c-MM/c-replicator/README.md

# c-replicator
stuff for the second c-replicator
