c-MM/c-replicator/3d-print/replicator-ZEN6-buttons-panel-v1.stl

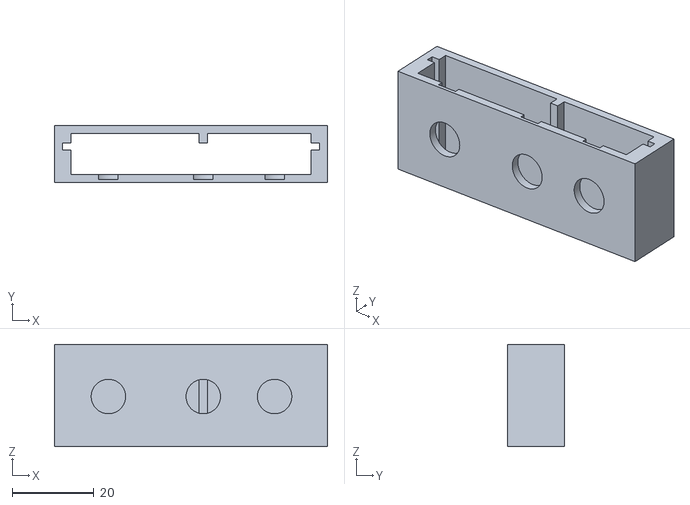
[picture p1: CAD file, 2019-01-27]
3d-print/replicator-ZEN6-buttons-panel-v1.stl
66.6 x 14.0 x 25.0
