c-MM/c-replicator/3d-print/replicator-ZEN6-cashbox-v1.stl

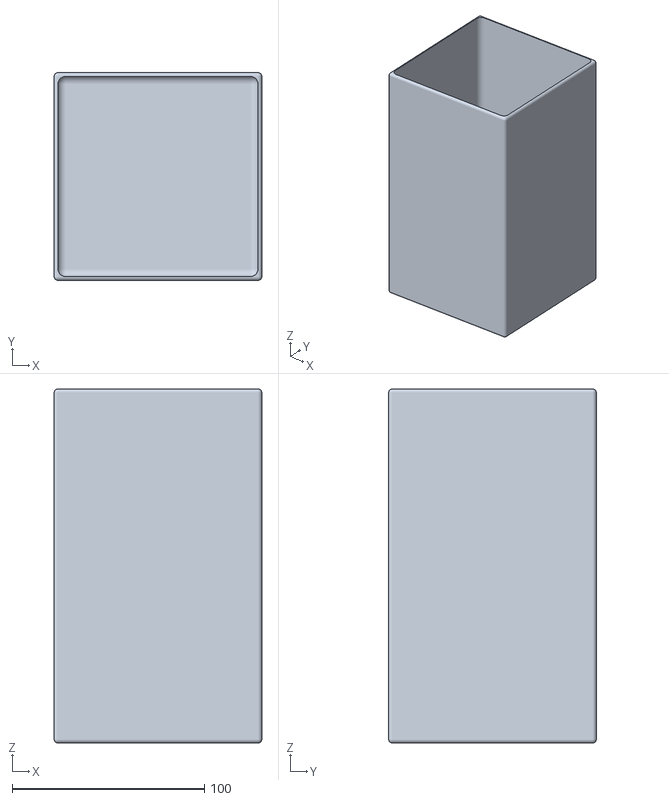
[picture p2: CAD file, 2019-01-26]
3d-print/replicator-ZEN6-cashbox-v1.stl
108.0 x 108.0 x 184.0
