c-MM/c-replicator/3d-print/replicator-ZEN6-connector_holder-v1.stl

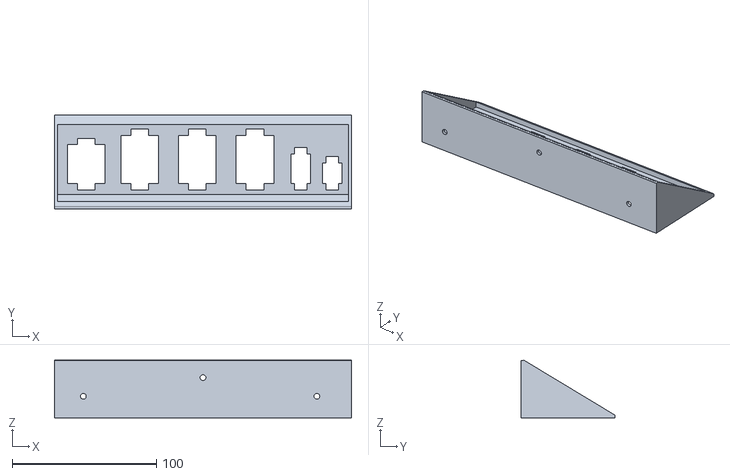
[picture p3: CAD file, 2019-01-20]
3d-print/replicator-ZEN6-connector_holder-v1.stl
206.0 x 65.0 x 40.1
