c-MM/c-replicator/kicad/logic/logic.pdf

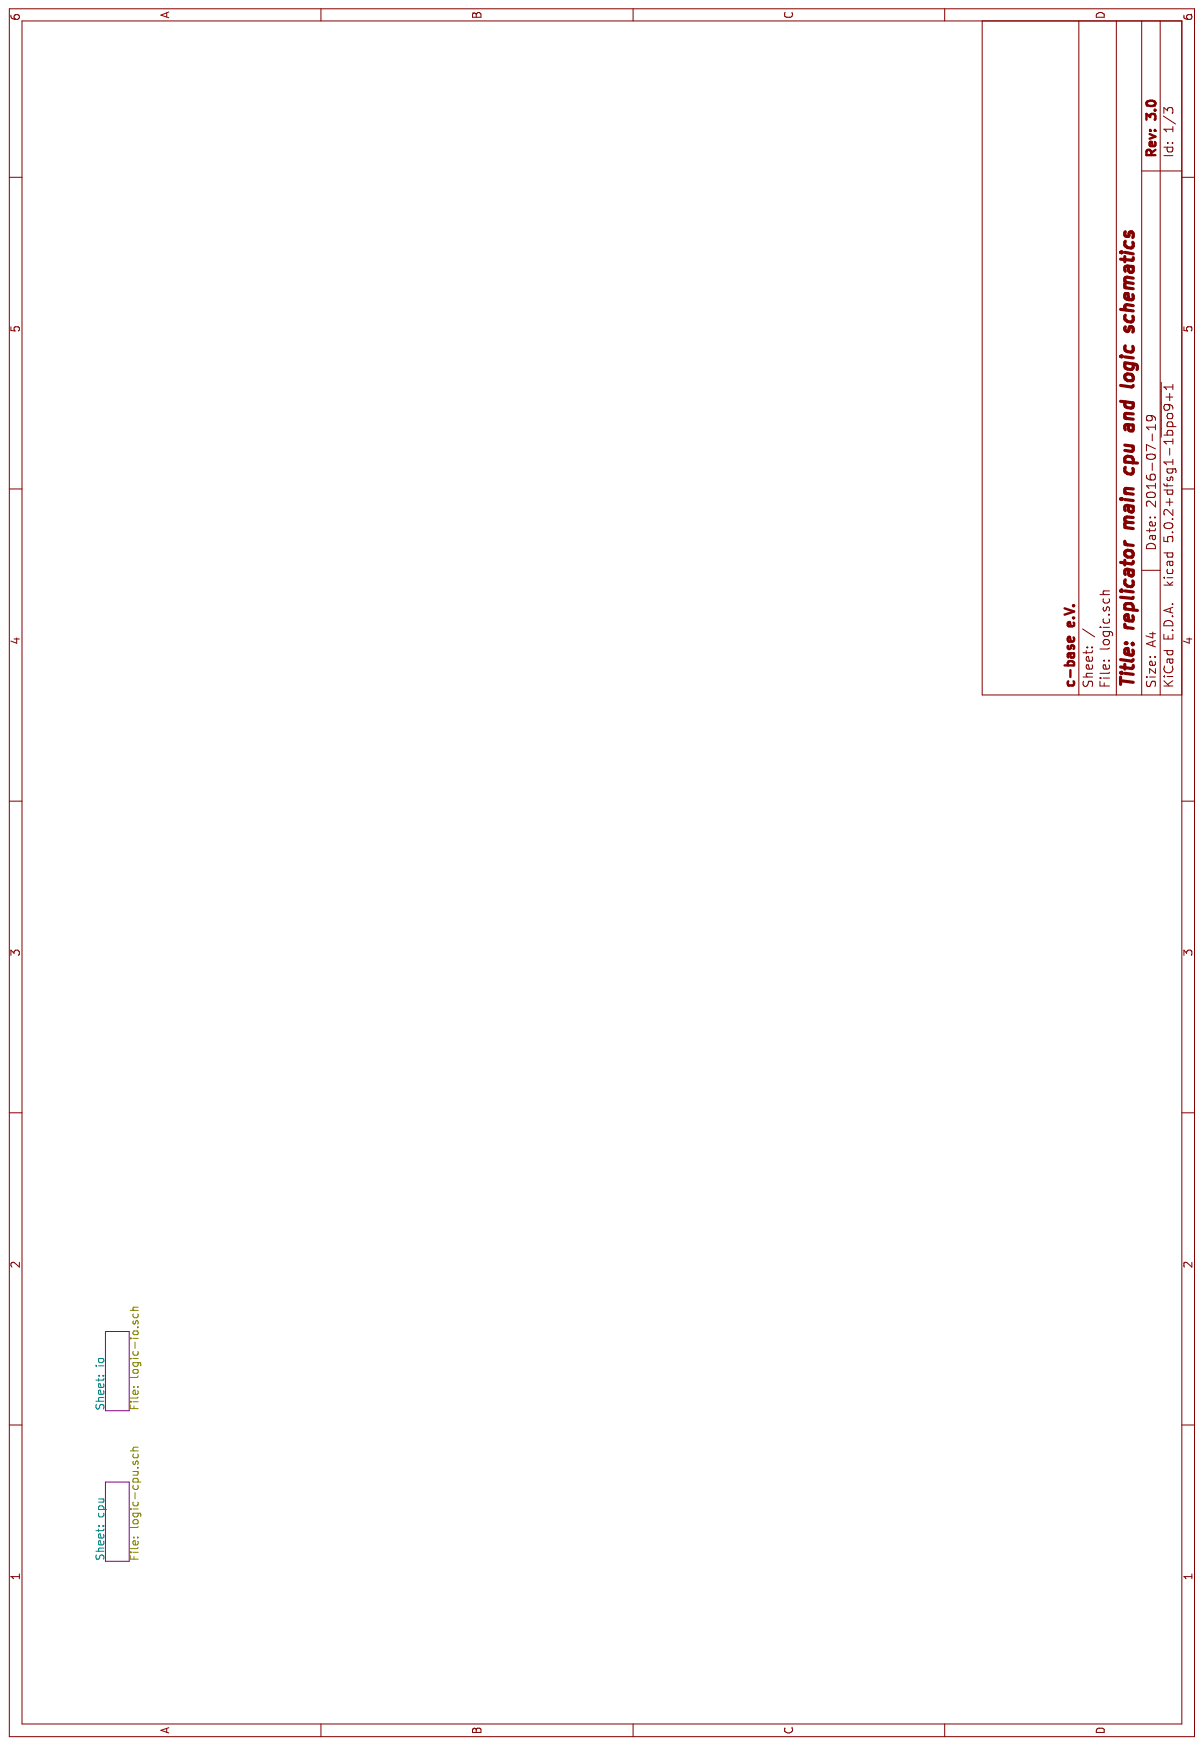
[picture p4: page 1]

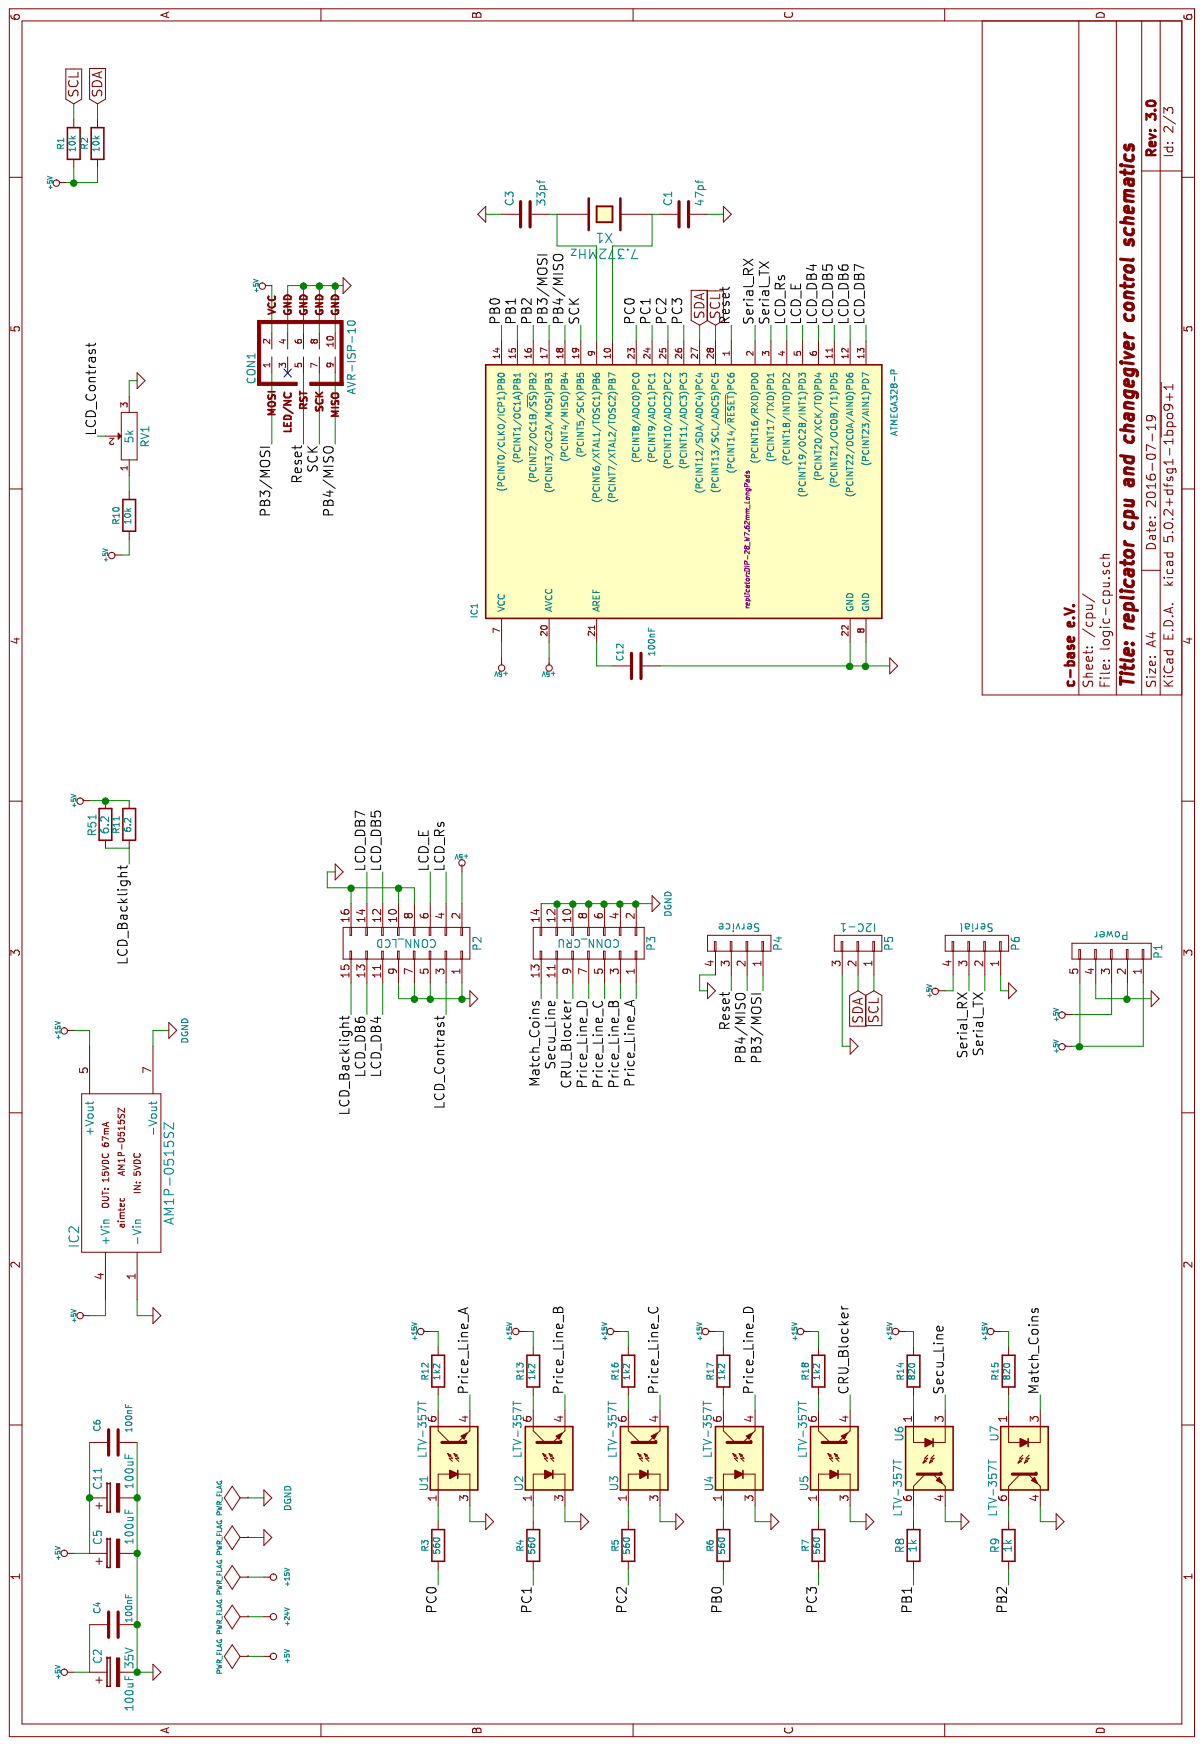
[picture p5: page 2]

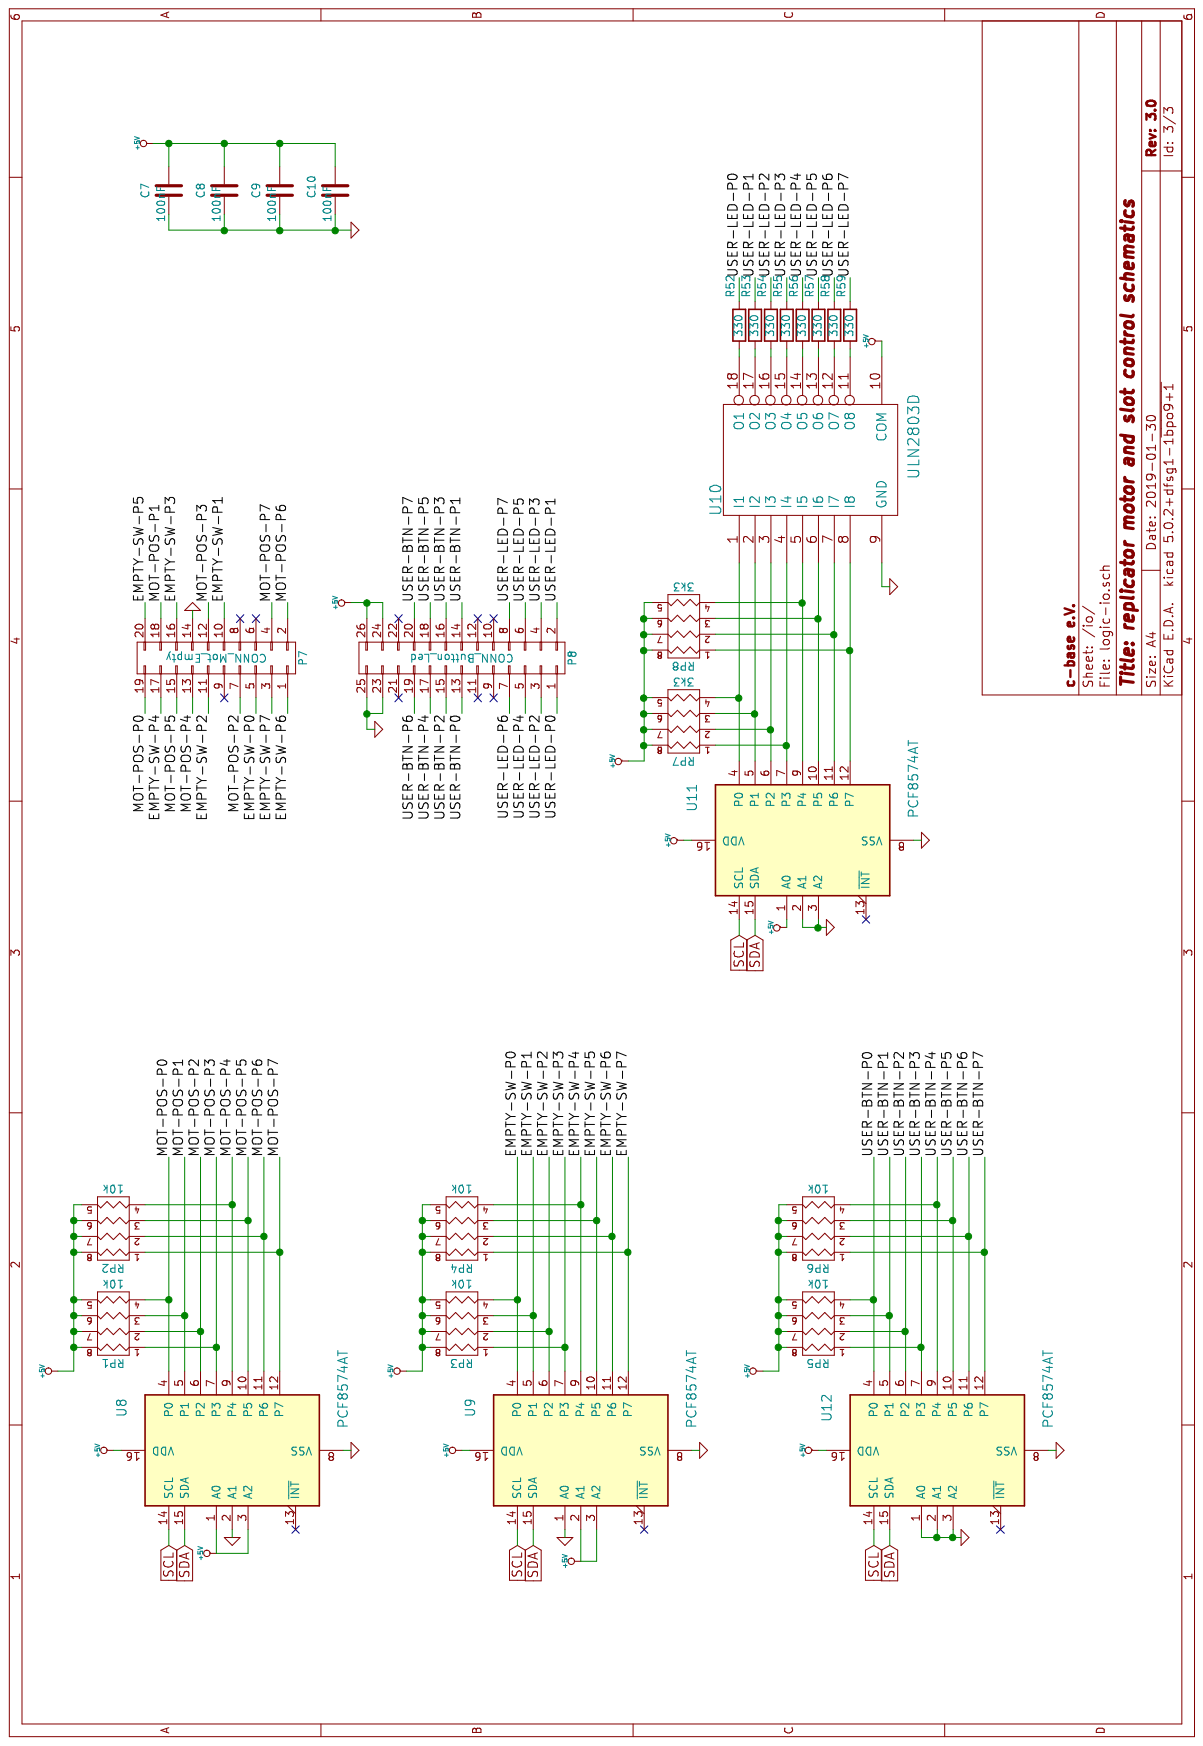
[picture p6: page 3]
