c-MM/c-replicator/kicad/power/power.pdf

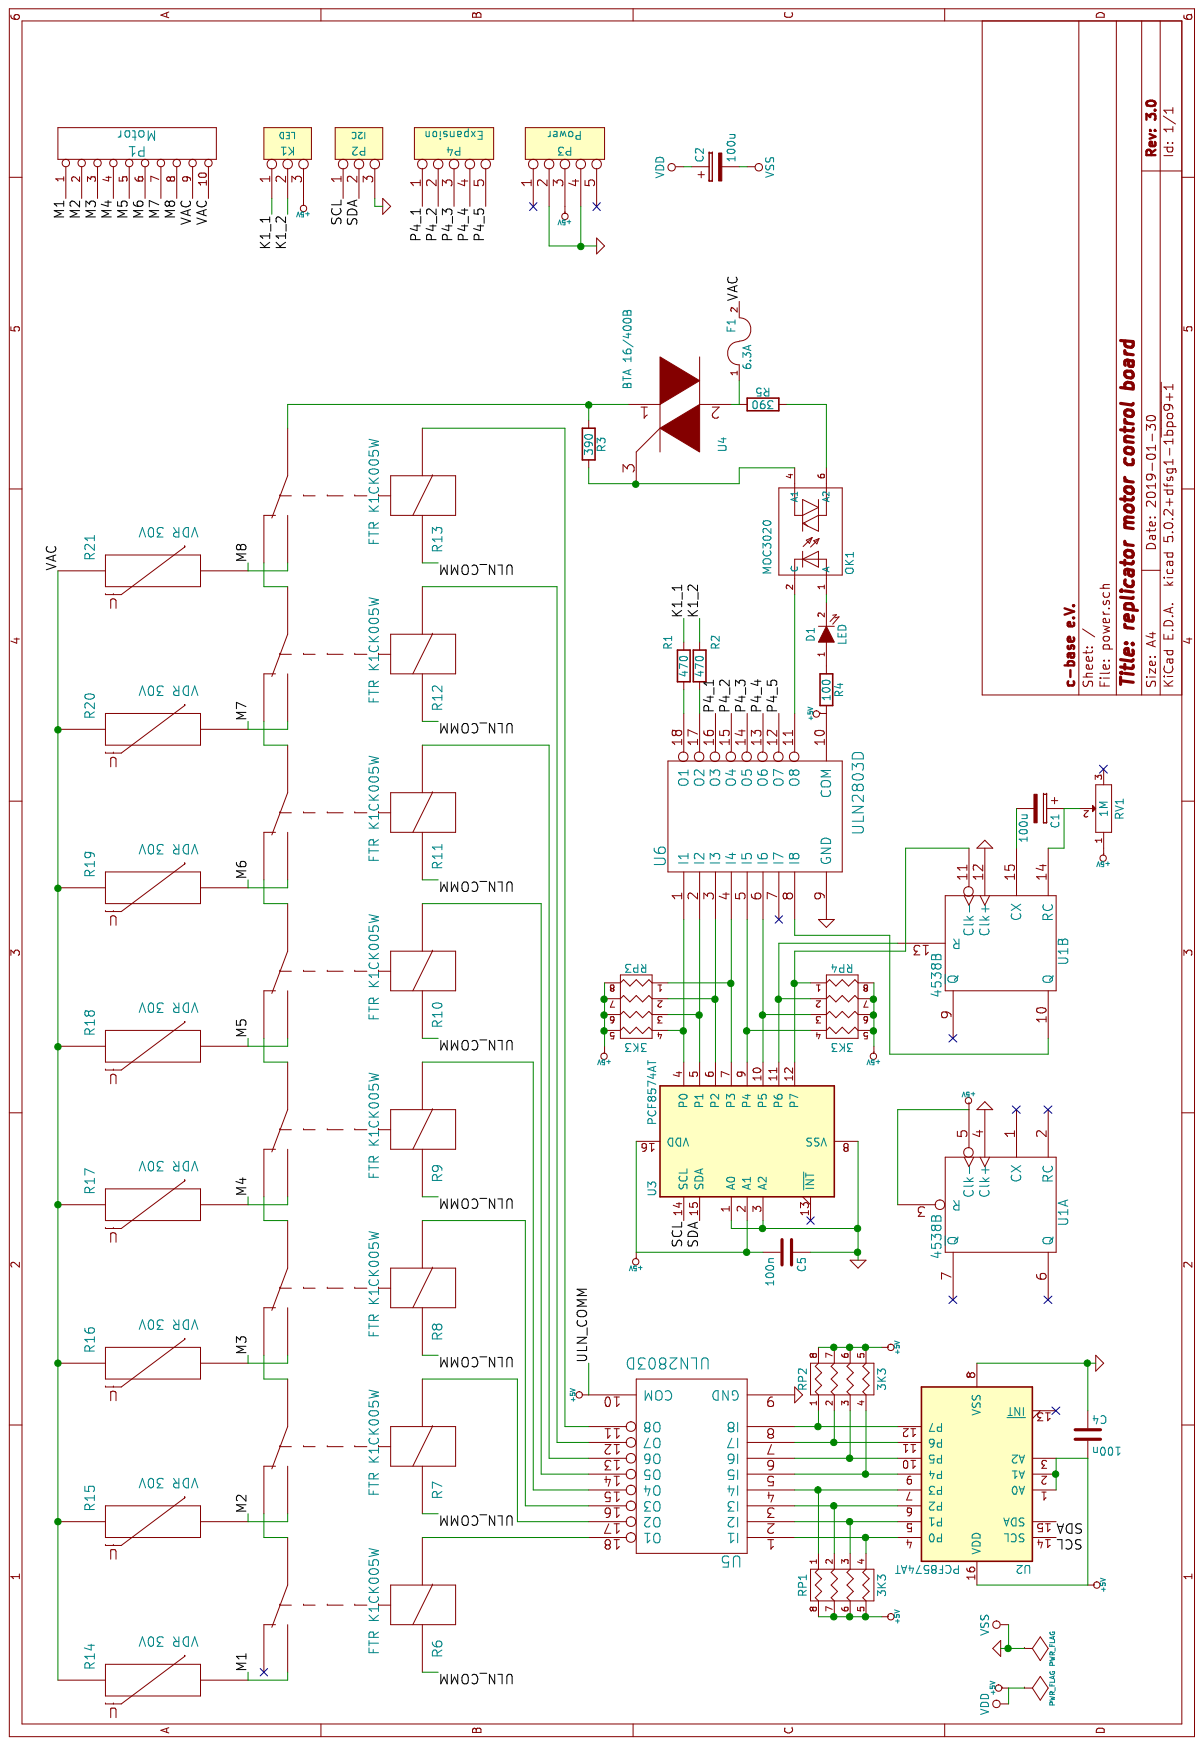
[picture p7: page 1]
