c-MM/c-replicator/kicad/power/power.kicad_pcb

## KiCad design kicad/power/power.kicad_pcb (2019-01-30)

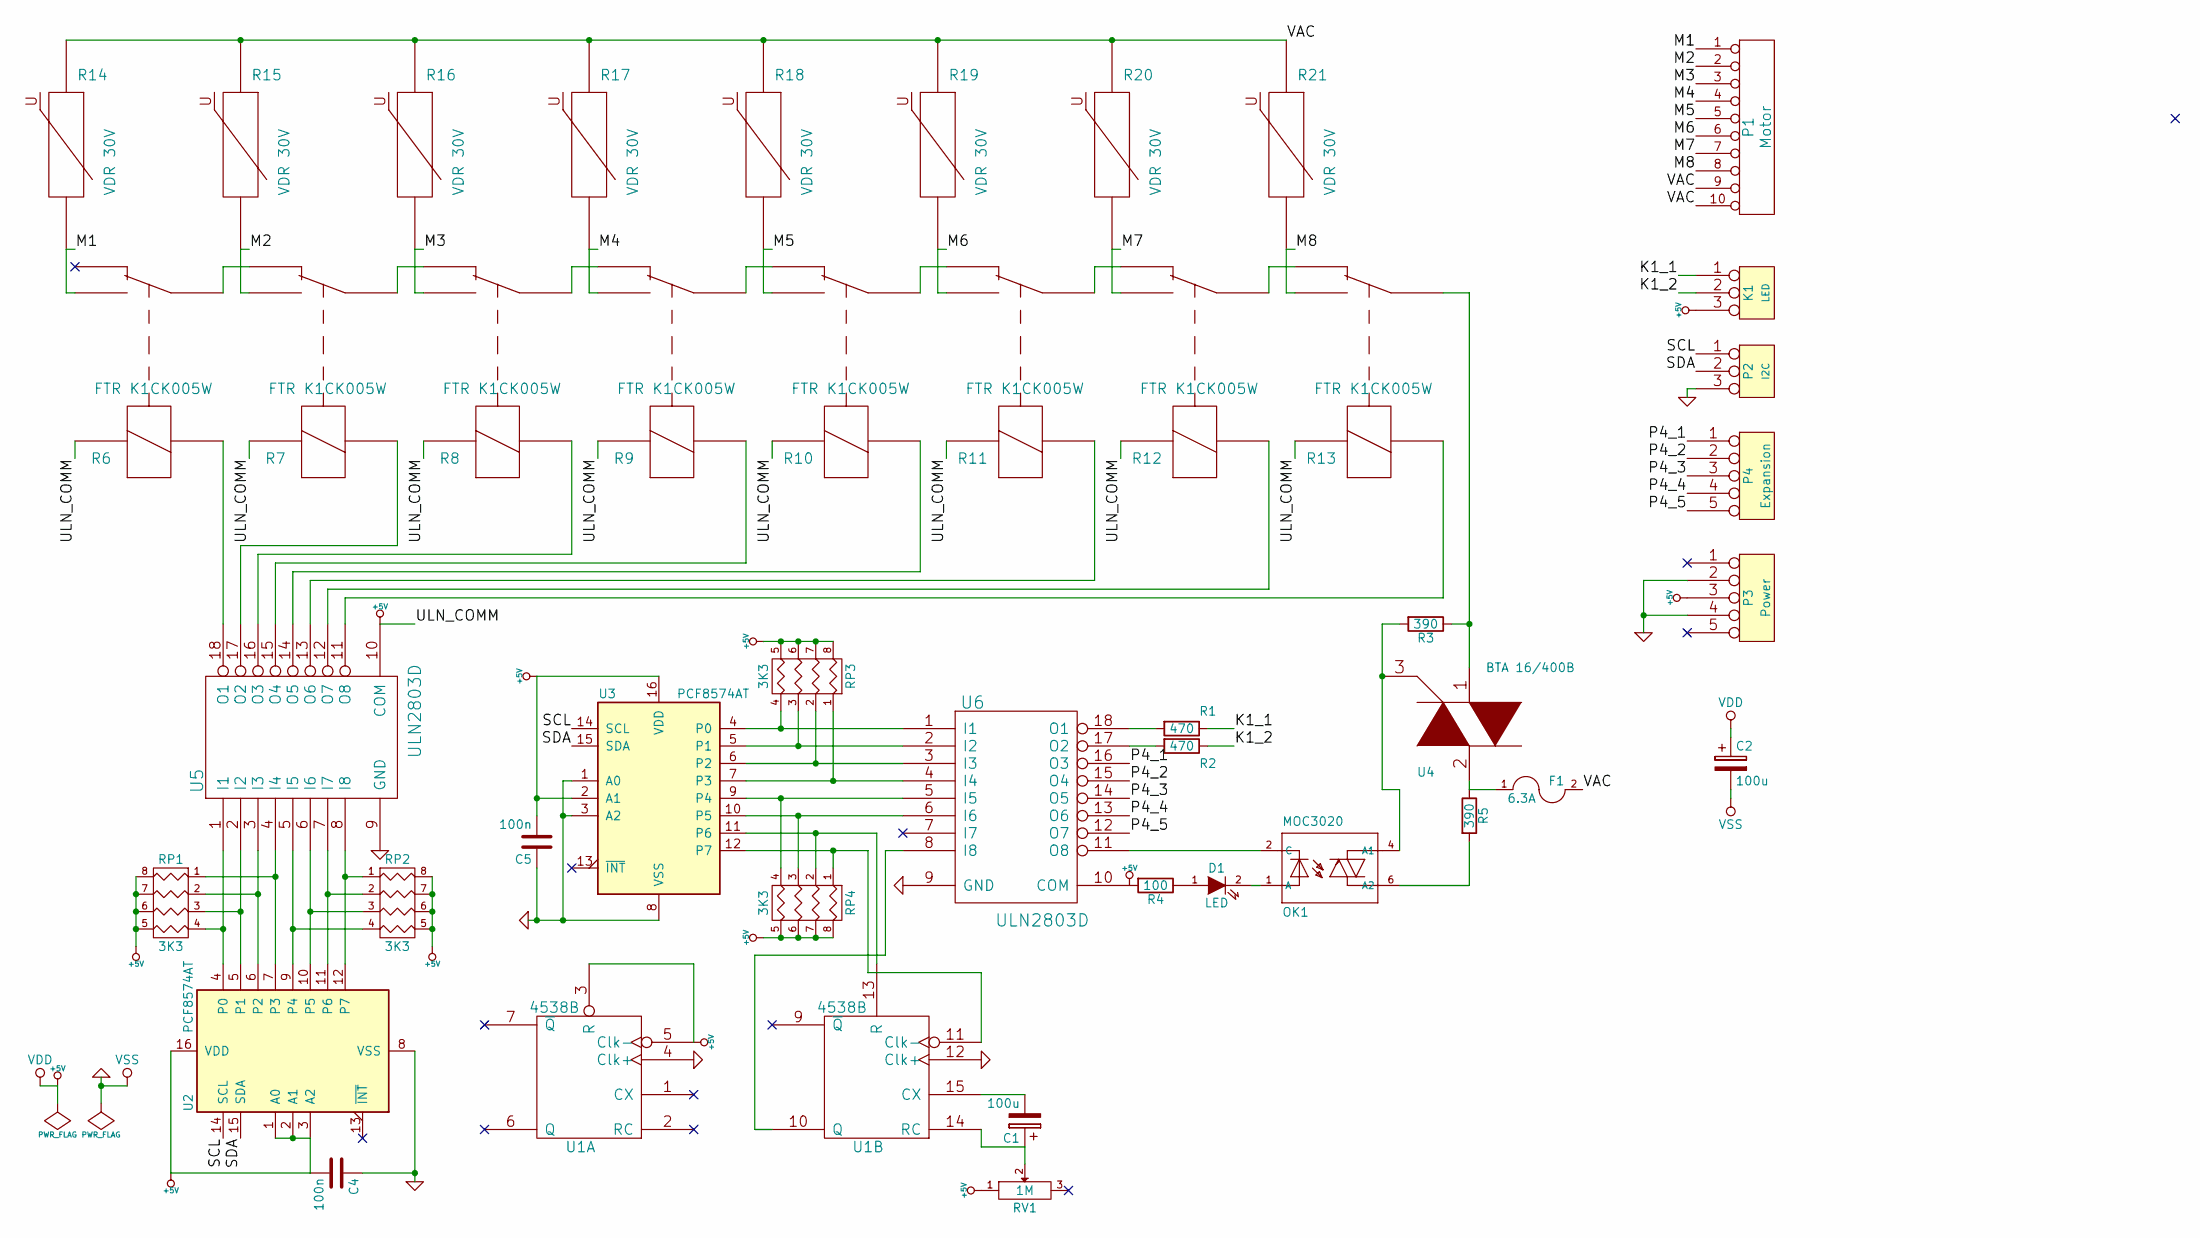
[picture p8: schematic power.sch, replicator motor control board]

Parts:
C1, C2: 100u; c_elec_6.3x5.8
C4, C5: 100n; C_0603_HandSoldering
D1: LED; LED-5MM
F1: 6.3A; Fuse_5mm
K1: LED; PSS254-3G
OK1: MOC3020; MOC_3020
P1: Motor; Akl_Ria_230_10
P2: I2C; PSS254-3G
P3: Power; PSS254-5G
P4: Expansion; PSS254-5G
R1, R2: 470; R_0603_HandSoldering
R3, R5: 390; R_0603_HandSoldering
R4: 100; R_0603_HandSoldering
R6, R7, R8, R9, R10, R11, R12, R13: FTR K1CK005W; Relais_1X
R14, R15, R16, R17, R18, R19, R20, R21: VDR 30V; R_1206_HandSoldering
RP1, RP2, RP3, RP4: 3K3; R_Array_Convex_4x1206
RV1: 1M; Potentiometer_Bourns_3296W_3-8Zoll_Inline_ScrewUp
U1: 4538B; SO-16-N
U2, U3: PCF8574AT; SOIC-16_7.5x10.3mm_Pitch1.27mm
U4: BTA 16/400B; TO220_VERT
U5, U6: ULN2803D; SOIC-18_7.5x11.6mm_Pitch1.27mm

Connections:
+5V: C2.1, C4.2, C5.2, K1.3, P3.3, R4.2, R6.1 (Spule_A), R7.1 (Spule_A), R8.1 (Spule_A), R9.1 (Spule_A), R10.1 (Spule_A), R11.1 (Spule_A), R12.1 (Spule_A), R13.1 (Spule_A), RP1.5 (R4), RP1.6 (R3), RP1.7 (R2), RP1.8 (R1), RP2.5 (R4), RP2.6 (R3), RP2.7 (R2), RP2.8 (R1), RP3.5 (R4), RP3.6 (R3), RP3.7 (R2), RP3.8 (R1), RP4.5 (R4), RP4.6 (R3), RP4.7 (R2), RP4.8 (R1), RV1.1, U1.3 (R), U1.5 (Clk-), U1.16 (VDD), U2.1 (A0), U2.2 (A1), U2.3 (A2), U2.16 (VDD), U3.2 (A1), U3.16 (VDD), U5.10 (COM), U6.10 (COM)
/K1_1: K1.1, R1.1
/K1_2: K1.2 (PM), R2.1
/M1: P1.1, R6.2 (NO), R14.2
/M2: P1.2, R7.2 (NO), R15.2
/M3: P1.3, R8.2 (NO), R16.2
/M4: P1.4, R9.2 (NO), R17.2
/M5: P1.5, R10.2 (NO), R18.2
/M6: P1.6, R11.2 (NO), R19.2
/M7: P1.7, R12.2 (NO), R20.2
/M8: P1.8, R13.2 (NO), R21.2
/P4_1: P4.1, U6.16 (O3)
/P4_2: P4.2, U6.15 (O4)
/P4_3: P4.3, U6.14 (O5)
/P4_4: P4.4, U6.13 (O6)
/P4_5: P4.5, U6.12 (O7)
/SCL: P2.1, U2.14 (SCL), U3.14 (SCL)
/SDA: P2.2 (PM), U2.15 (SDA), U3.15 (SDA)
/VAC: F1.2, P1.9, P1.10, R14.1, R15.1, R16.1, R17.1, R18.1, R19.1, R20.1, R21.1
GND: C2.2, C4.1, C5.1, P2.3, P3.2, P3.4, U1.4 (Clk+), U1.8 (VSS), U1.12 (Clk+), U2.8 (VSS), U3.1 (A0), U3.3 (A2), U3.8 (VSS), U5.9 (GND), U6.9 (GND)
unnamed: C1.1, RV1.2, U1.14 (RC)
unnamed: C1.2, U1.15 (CX)
unnamed: D1.1 (A), R4.1
unnamed: D1.2 (K), OK1.1 (A)
unnamed: F1.1, R5.1, U4.2
unnamed: OK1.2 (C), U6.11 (O8)
unnamed: OK1.4 (A1), R3.2, U4.3
unnamed: OK1.6 (A2), R5.2
unnamed: R1.2, U6.18 (O1)
unnamed: R2.2, U6.17 (O2)
unnamed: R6.3 (Spule_B), U5.18 (O1)
unnamed: R6.5 (C), R7.4 (NC)
unnamed: R7.3 (Spule_B), U5.17 (O2)
unnamed: R7.5 (C), R8.4 (NC)
unnamed: R8.3 (Spule_B), U5.16 (O3)
unnamed: R8.5 (C), R9.4 (NC)
unnamed: R9.3 (Spule_B), U5.15 (O4)
unnamed: R10.3 (Spule_B), U5.14 (O5)
unnamed: R9.5 (C), R10.4 (NC)
unnamed: R10.5 (C), R11.4 (NC)
unnamed: R11.3 (Spule_B), U5.13 (O6)
unnamed: R11.5 (C), R12.4 (NC)
unnamed: R12.3 (Spule_B), U5.12 (O7)
unnamed: R12.5 (C), R13.4 (NC)
unnamed: R13.3 (Spule_B), U5.11 (O8)
unnamed: R3.1, R13.5 (C), U4.1
unnamed: RP1.1, U2.7 (P3), U5.4 (I4)
unnamed: RP1.2, U2.6 (P2), U5.3 (I3)
unnamed: RP1.3, U2.5 (P1), U5.2 (I2)
unnamed: RP1.4, U2.4 (P0), U5.1 (I1)
unnamed: RP2.1, U2.12 (P7), U5.8 (I8)
unnamed: RP2.2, U2.11 (P6), U5.7 (I7)
unnamed: RP2.3, U2.10 (P5), U5.6 (I6)
unnamed: RP2.4, U2.9 (P4), U5.5 (I5)
unnamed: RP3.1, U3.7 (P3), U6.4 (I4)
unnamed: RP3.2, U3.6 (P2), U6.3 (I3)
unnamed: RP3.3, U3.5 (P1), U6.2 (I2)
unnamed: RP3.4, U3.4 (P0), U6.1 (I1)
unnamed: RP4.1, U1.11 (Clk-), U3.12 (P7)
unnamed: RP4.2, U1.13 (R), U3.11 (P6)
unnamed: RP4.3, U3.10 (P5), U6.6 (I6)
unnamed: RP4.4, U3.9 (P4), U6.5 (I5)
unnamed: U1.10 (Q), U6.8 (I8)

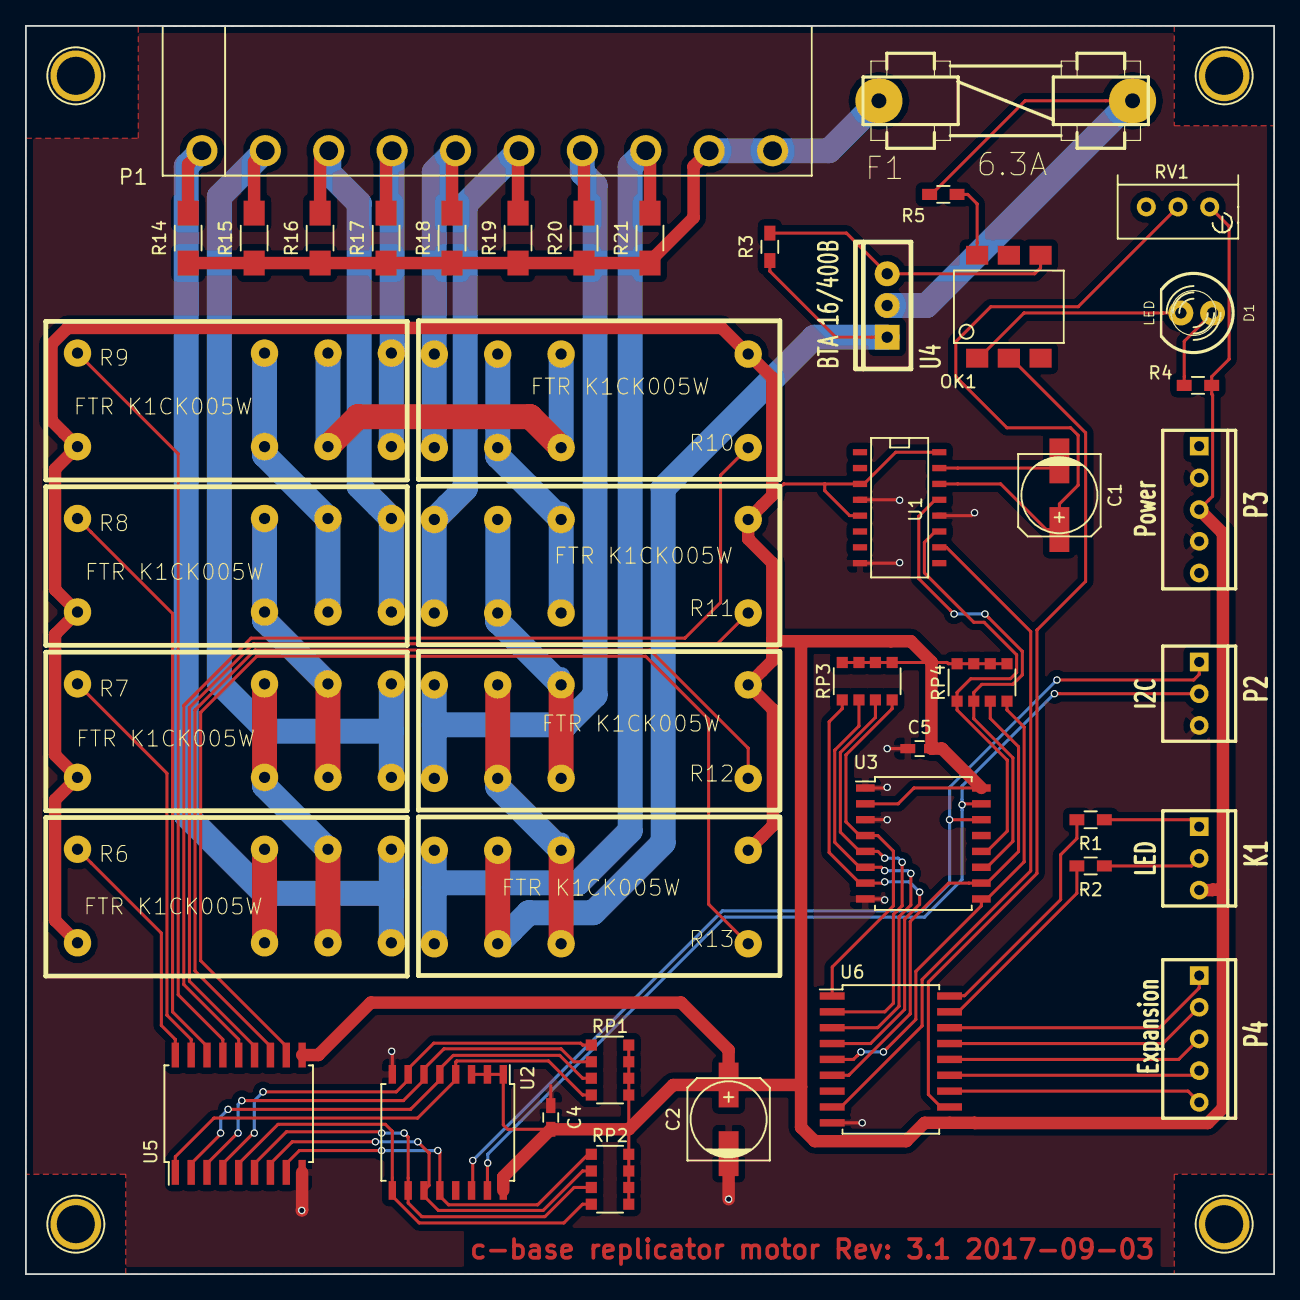
[picture p9: board power.kicad_pcb from above]

Board: 2 copper layers, 100.0 x 100.0 mm, 44 parts (0 on the bottom side), 63 nets.
