c-MM/c-replicator/kicad/logic/logic.kicad_pcb

## KiCad design kicad/logic/logic.kicad_pcb (2019-01-30)

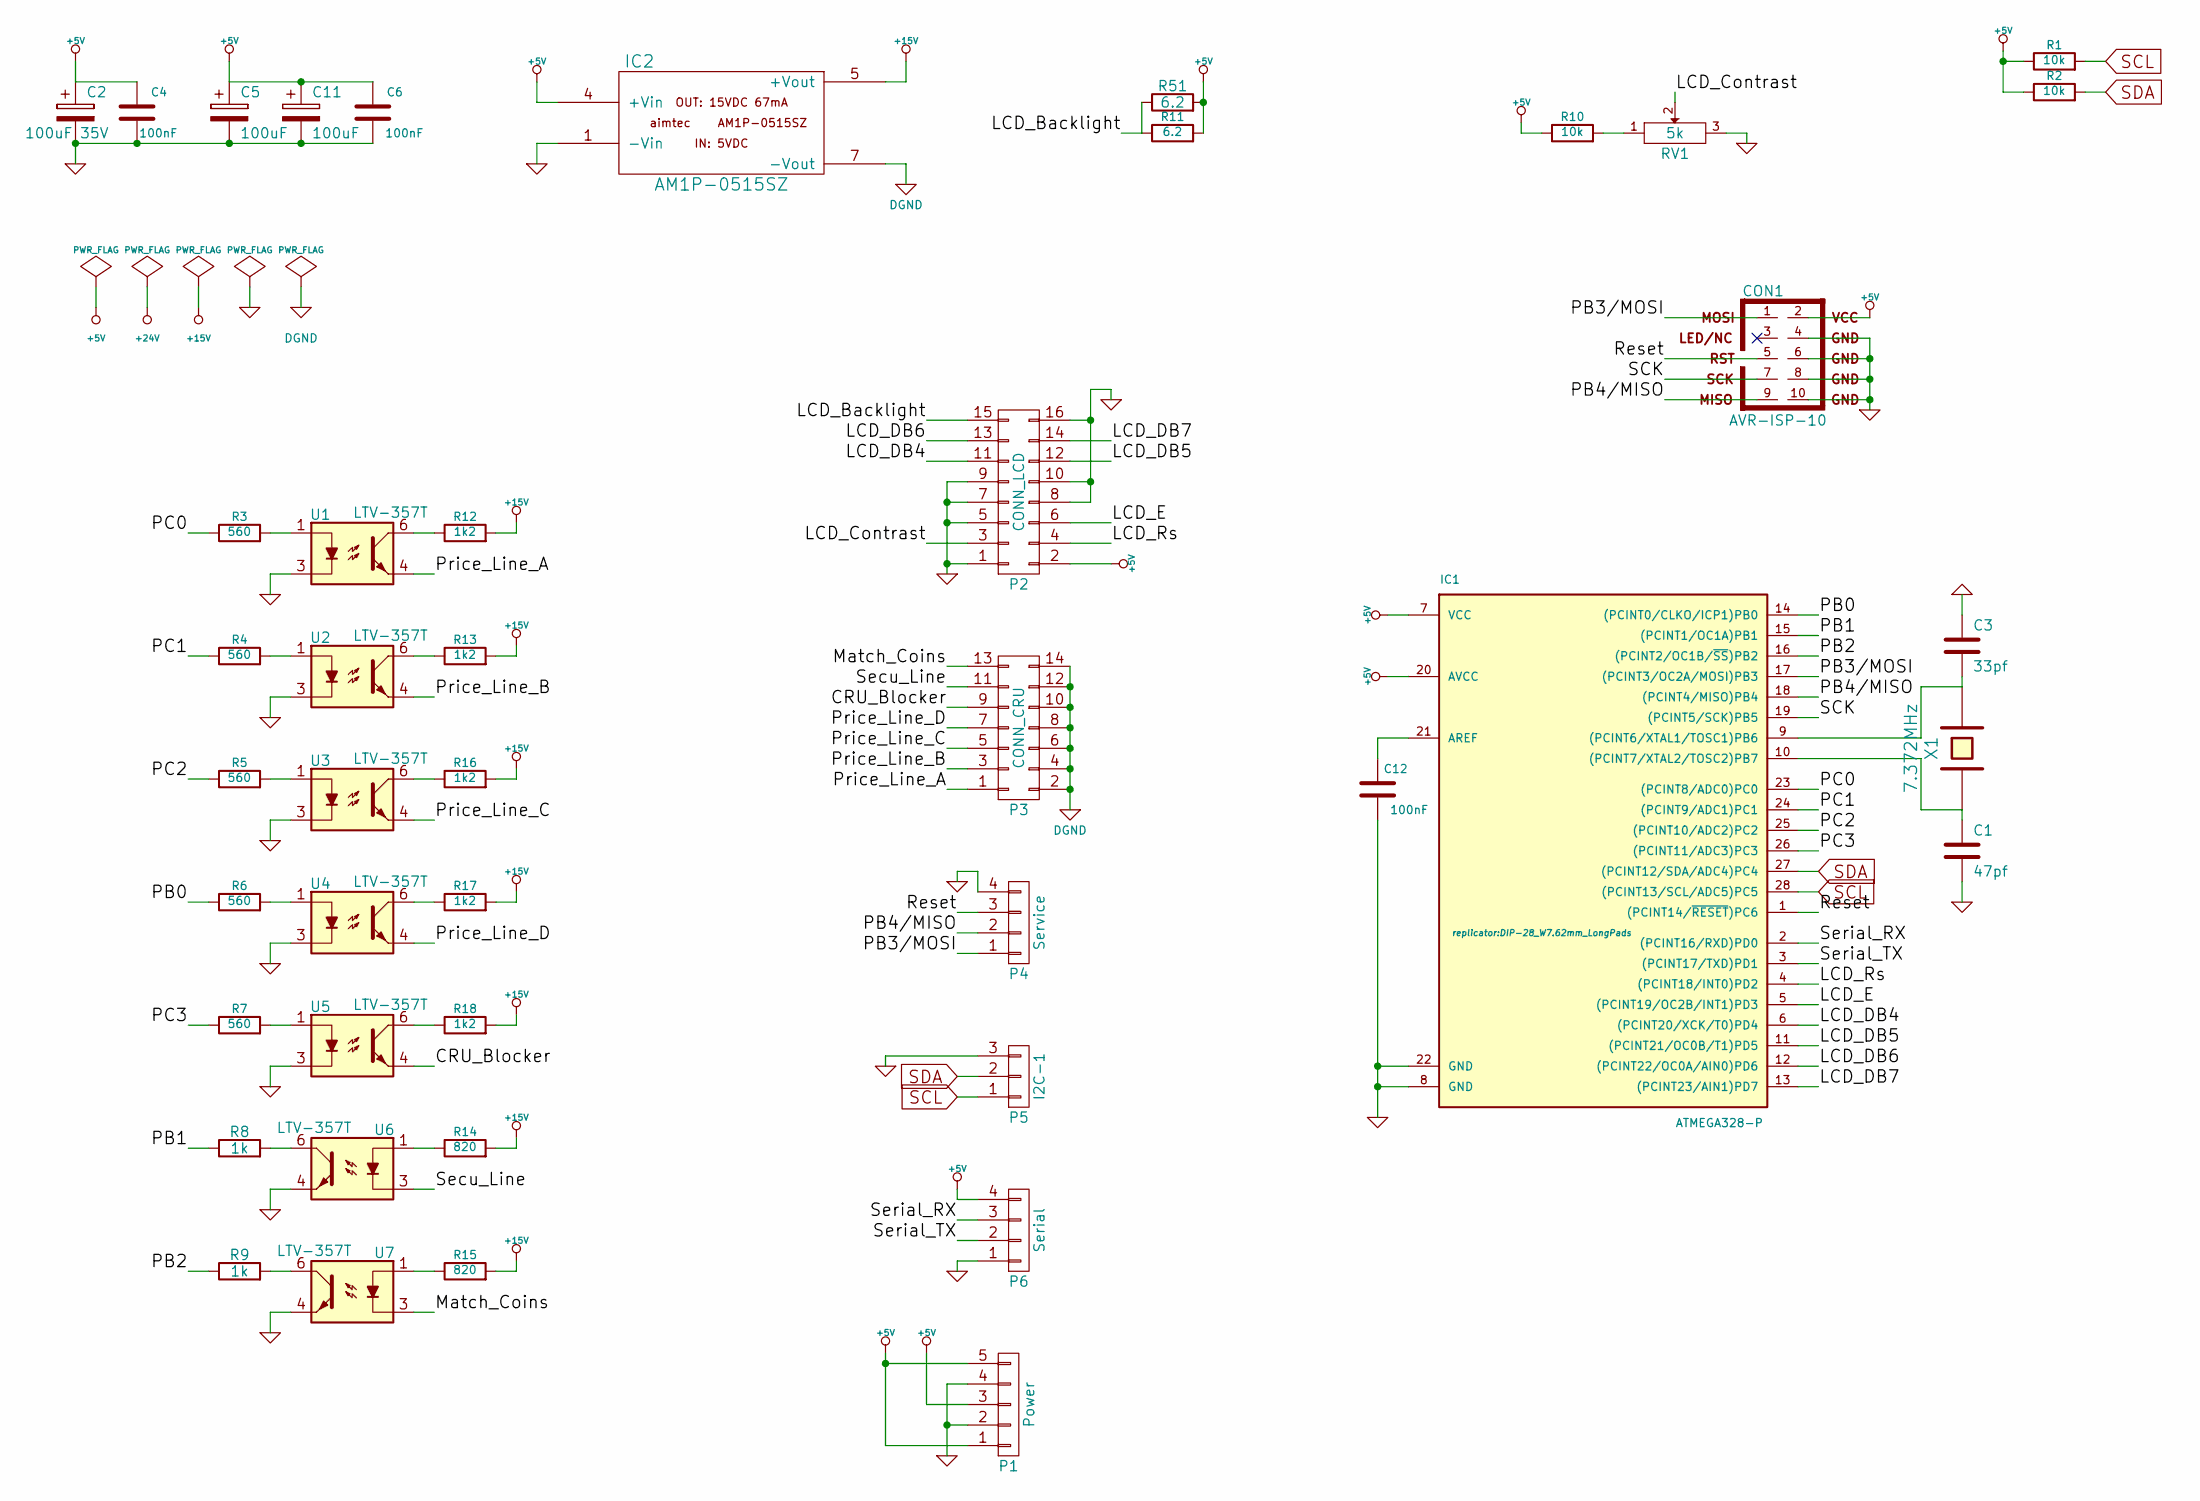
[picture p10: schematic logic-cpu.sch, replicator cpu and changegiver control schematics]

Parts:
C1: 47pf; C_0603_HandSoldering
C2: 100uF 35V; c_elec_6.3x7.7
C3: 33pf; C_0603_HandSoldering
C4, C6, C12: 100nF; C_0603_HandSoldering
C5, C11: 100uF; c_elec_6.3x5.8
CON1: AVR-ISP-10; IDC_Header_Straight_10pins
IC1: ATMEGA328-P; DIP-28_W7.62mm_LongPads
IC2: AM1P-0515SZ; DIP-8_W7.62mm_LongPads
P1: Power; PSS254-5G
P2: CONN_LCD; IDC_Header_Straight_16pins
P3: CONN_CRU; IDC_Header_Straight_14pins
P4: Service; PSS254-4G
P5: I2C-1; PSS254-3G
P6: Serial; PSS254-4G
R1, R2, R10: 10k; R_0603_HandSoldering
R3, R4, R5, R6, R7: 560; R_0603_HandSoldering
R8, R9: 1k; R_0603_HandSoldering
R11, R51: 6.2; R_1206_HandSoldering
R12, R13, R16, R17, R18: 1k2; R_1206_HandSoldering
R14, R15: 820; R_1206_HandSoldering
RV1: 5k; Potentiometer_Trimmer-Suntan-TSR-3386P
U1, U2, U3, U4, U5, U6, U7: LTV-357T; Optocoupler_SMD_HandSoldering_KPC357_LTV35x_PC357_SingleCha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
X1: 7.372MHz; Crystal_HC49-U_Vertical

Connections:
+15V: IC2.5 (+Vout), R12.2, R13.2, R14.2, R15.2, R16.2, R17.2, R18.2
/cpu/CRU_Blocker: P3.9, U5.4
/cpu/LCD_Backlight: P2.15, R11.1, R51.1
/cpu/LCD_Contrast: P2.3, RV1.2
/cpu/LCD_DB4: IC1.6 ((PCINT20/XCK/T0)PD4), P2.11
/cpu/LCD_DB5: IC1.11 ((PCINT21/OC0B/T1)PD5), P2.12
/cpu/LCD_DB6: IC1.12 ((PCINT22/OC0A/AIN0)PD6), P2.13
/cpu/LCD_DB7: IC1.13 ((PCINT23/AIN1)PD7), P2.14
/cpu/LCD_E: IC1.5 ((PCINT19/OC2B/INT1)PD3), P2.6
/cpu/LCD_Rs: IC1.4 ((PCINT18/INT0)PD2), P2.4
/cpu/Match_Coins: P3.13, U7.3
/cpu/PB0: IC1.14 ((PCINT0/CLKO/ICP1)PB0), R6.1
/cpu/PB1: IC1.15 ((PCINT1/OC1A)PB1), R8.1
/cpu/PB2: IC1.16 ((PCINT2/OC1B/~SS~)PB2), R9.1
/cpu/PB3/MOSI: CON1.1, IC1.17 ((PCINT3/OC2A/MOSI)PB3), P4.1
/cpu/PB4/MISO: CON1.9, IC1.18 ((PCINT4/MISO)PB4), P4.2
/cpu/PC0: IC1.23 ((PCINT8/ADC0)PC0), R3.1
/cpu/PC1: IC1.24 ((PCINT9/ADC1)PC1), R4.1
/cpu/PC2: IC1.25 ((PCINT10/ADC2)PC2), R5.1
/cpu/PC3: IC1.26 ((PCINT11/ADC3)PC3), R7.1
/cpu/Price_Line_A: P3.1, U1.4
/cpu/Price_Line_B: P3.3, U2.4
/cpu/Price_Line_C: P3.5, U3.4
/cpu/Price_Line_D: P3.7, U4.4
/cpu/Reset: CON1.5, IC1.1 ((PCINT14/~RESET~)PC6), P4.3
/cpu/SCK: CON1.7, IC1.19 ((PCINT5/SCK)PB5)
/cpu/Secu_Line: P3.11, U6.3
/cpu/Serial_RX: IC1.2 ((PCINT16/RXD)PD0), P6.3
/cpu/Serial_TX: IC1.3 ((PCINT17/TXD)PD1), P6.2
DGND: IC2.7 (-Vout), P3.2, P3.4, P3.6, P3.8, P3.10, P3.12, P3.14
unnamed: C1.1, IC1.10 ((PCINT7/XTAL2/TOSC2)PB7), X1.2
unnamed: C3.2, IC1.9 ((PCINT6/XTAL1/TOSC1)PB6), X1.1
unnamed: C12.2, IC1.21 (AREF)
unnamed: R3.2, U1.1
unnamed: R4.2, U2.1
unnamed: R5.2, U3.1
unnamed: R6.2, U4.1
unnamed: R7.2, U5.1
unnamed: R8.2, U6.6
unnamed: R9.2, U7.6
unnamed: R10.2, RV1.1
unnamed: R12.1, U1.6
unnamed: R13.1, U2.6
unnamed: R14.1, U6.1
unnamed: R15.1, U7.1
unnamed: R16.1, U3.6
unnamed: R17.1, U4.6
unnamed: R18.1, U5.6
SDA: IC1.27 ((PCINT12/SDA/ADC4)PC4), P5.2, R2.2; also elsewhere on the board

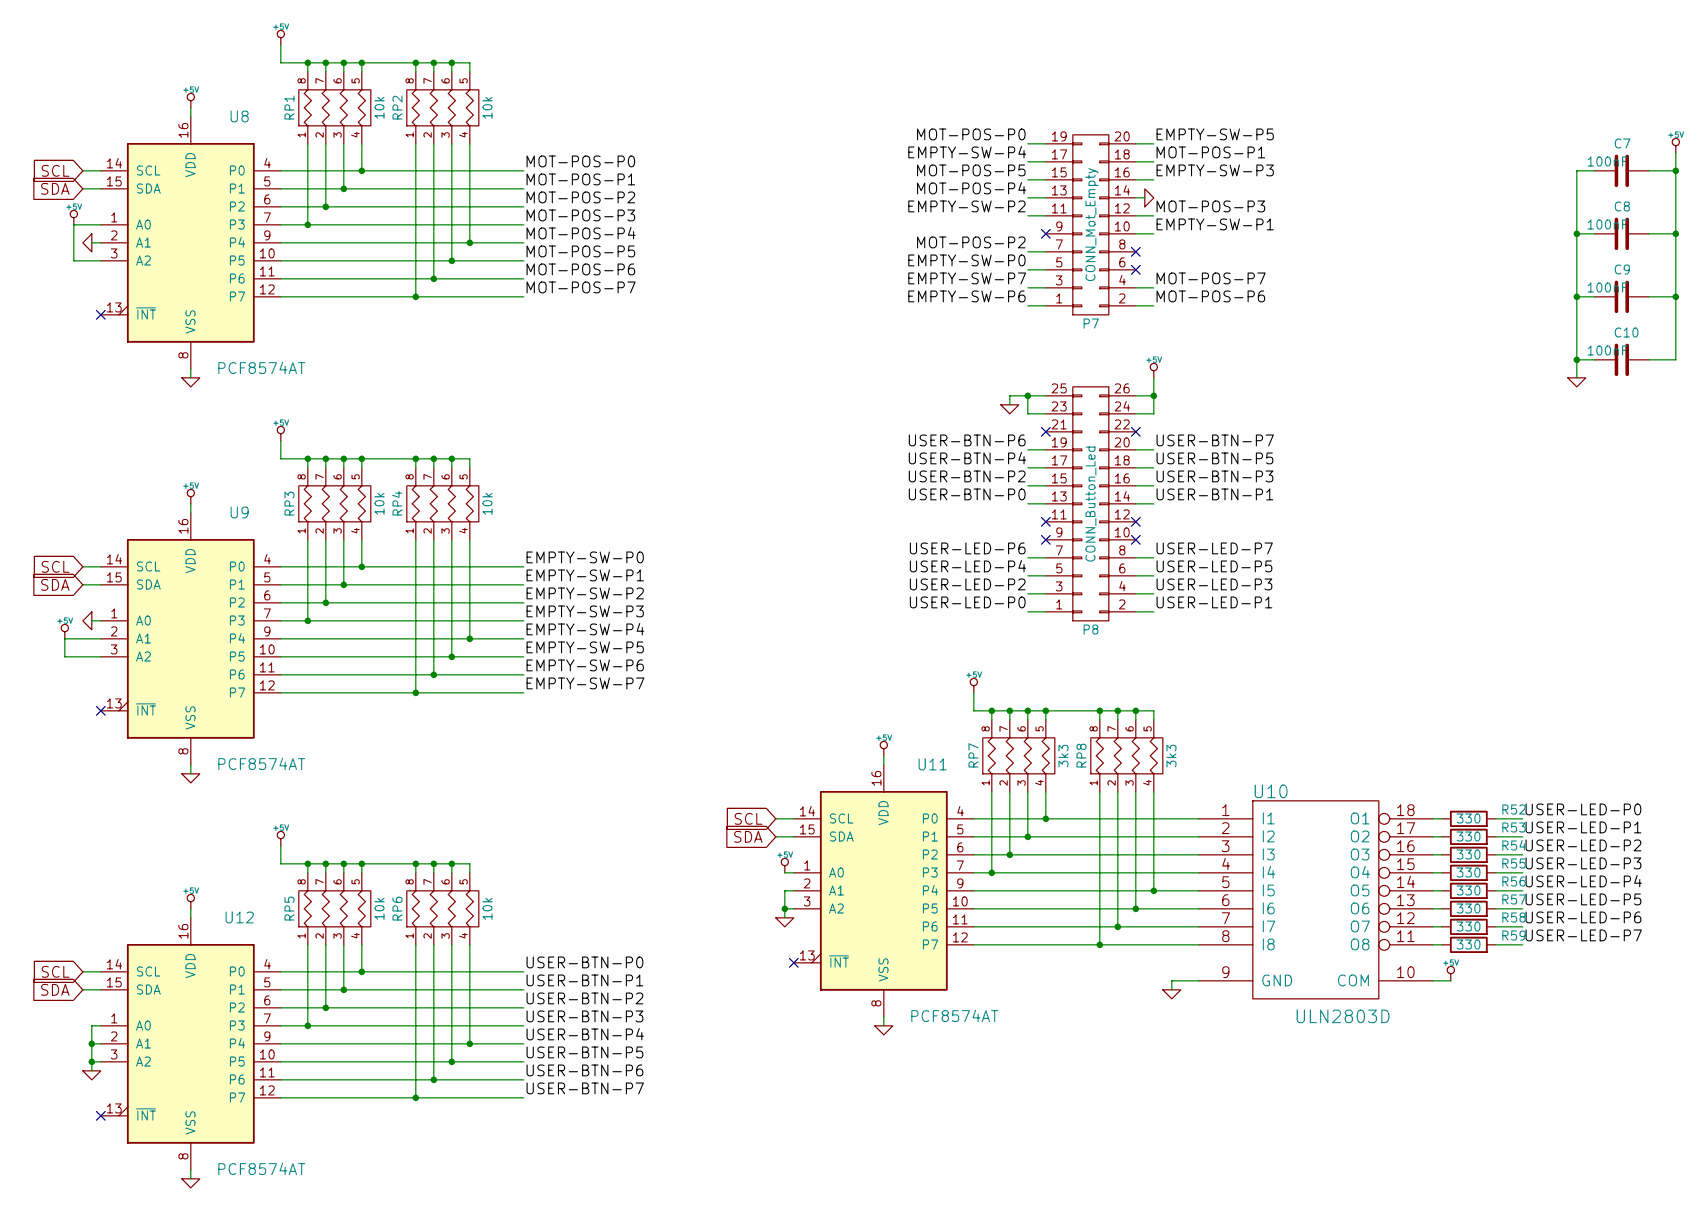
[picture p11: schematic logic-io.sch, replicator motor and slot control schematics]

Parts:
C7, C8, C9, C10: 100nF; C_0603_HandSoldering
P7: CONN_Mot_Empty; IDC_Header_Straight_20pins
P8: CONN_Button_Led; IDC_Header_Straight_26pins
R52, R53, R54, R55, R56, R57, R58, R59: 330; R_0603_HandSoldering
RP1, RP2, RP3, RP4, RP5, RP6: 10k; R_Array_Convex_4x1206
RP7, RP8: 3k3; R_Array_Convex_4x1206
U8, U9, U11, U12: PCF8574AT; SOIC-16_7.5x10.3mm_Pitch1.27mm
U10: ULN2803D; SOIC-18_7.5x11.6mm_Pitch1.27mm

Connections:
/io/EMPTY-SW-P0: P7.5, RP3.4, U9.4 (P0)
/io/EMPTY-SW-P1: P7.10, RP3.3, U9.5 (P1)
/io/EMPTY-SW-P2: P7.11, RP3.2, U9.6 (P2)
/io/EMPTY-SW-P3: P7.16, RP3.1, U9.7 (P3)
/io/EMPTY-SW-P4: P7.17, RP4.4, U9.9 (P4)
/io/EMPTY-SW-P5: P7.20, RP4.3, U9.10 (P5)
/io/EMPTY-SW-P6: P7.1, RP4.2, U9.11 (P6)
/io/EMPTY-SW-P7: P7.3, RP4.1, U9.12 (P7)
/io/MOT-POS-P0: P7.19, RP1.4, U8.4 (P0)
/io/MOT-POS-P1: P7.18, RP1.3, U8.5 (P1)
/io/MOT-POS-P2: P7.7, RP1.2, U8.6 (P2)
/io/MOT-POS-P3: P7.12, RP1.1, U8.7 (P3)
/io/MOT-POS-P4: P7.13, RP2.4, U8.9 (P4)
/io/MOT-POS-P5: P7.15, RP2.3, U8.10 (P5)
/io/MOT-POS-P6: P7.2, RP2.2, U8.11 (P6)
/io/MOT-POS-P7: P7.4, RP2.1, U8.12 (P7)
/io/USER-BTN-P0: P8.13, RP5.4, U12.4 (P0)
/io/USER-BTN-P1: P8.14, RP5.3, U12.5 (P1)
/io/USER-BTN-P2: P8.15, RP5.2, U12.6 (P2)
/io/USER-BTN-P3: P8.16, RP5.1, U12.7 (P3)
/io/USER-BTN-P4: P8.17, RP6.4, U12.9 (P4)
/io/USER-BTN-P5: P8.18, RP6.3, U12.10 (P5)
/io/USER-BTN-P6: P8.19, RP6.2, U12.11 (P6)
/io/USER-BTN-P7: P8.20, RP6.1, U12.12 (P7)
/io/USER-LED-P0: P8.1, R52.2
/io/USER-LED-P1: P8.2, R53.2
/io/USER-LED-P2: P8.3, R54.2
/io/USER-LED-P3: P8.4, R55.2
/io/USER-LED-P4: P8.5, R56.2
/io/USER-LED-P5: P8.6, R57.2
/io/USER-LED-P6: P8.7, R58.2
/io/USER-LED-P7: P8.8, R59.2
unnamed: R52.1, U10.18 (O1)
unnamed: R53.1, U10.17 (O2)
unnamed: R54.1, U10.16 (O3)
unnamed: R55.1, U10.15 (O4)
unnamed: R56.1, U10.14 (O5)
unnamed: R57.1, U10.13 (O6)
unnamed: R58.1, U10.12 (O7)
unnamed: R59.1, U10.11 (O8)
unnamed: RP7.1, U10.4 (I4), U11.7 (P3)
unnamed: RP7.2, U10.3 (I3), U11.6 (P2)
unnamed: RP7.3, U10.2 (I2), U11.5 (P1)
unnamed: RP7.4, U10.1 (I1), U11.4 (P0)
unnamed: RP8.1, U10.8 (I8), U11.12 (P7)
unnamed: RP8.2, U10.7 (I7), U11.11 (P6)
unnamed: RP8.3, U10.6 (I6), U11.10 (P5)
unnamed: RP8.4, U10.5 (I5), U11.9 (P4)
SDA: U8.15 (SDA), U9.15 (SDA), U11.15 (SDA), U12.15 (SDA); also elsewhere on the board

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
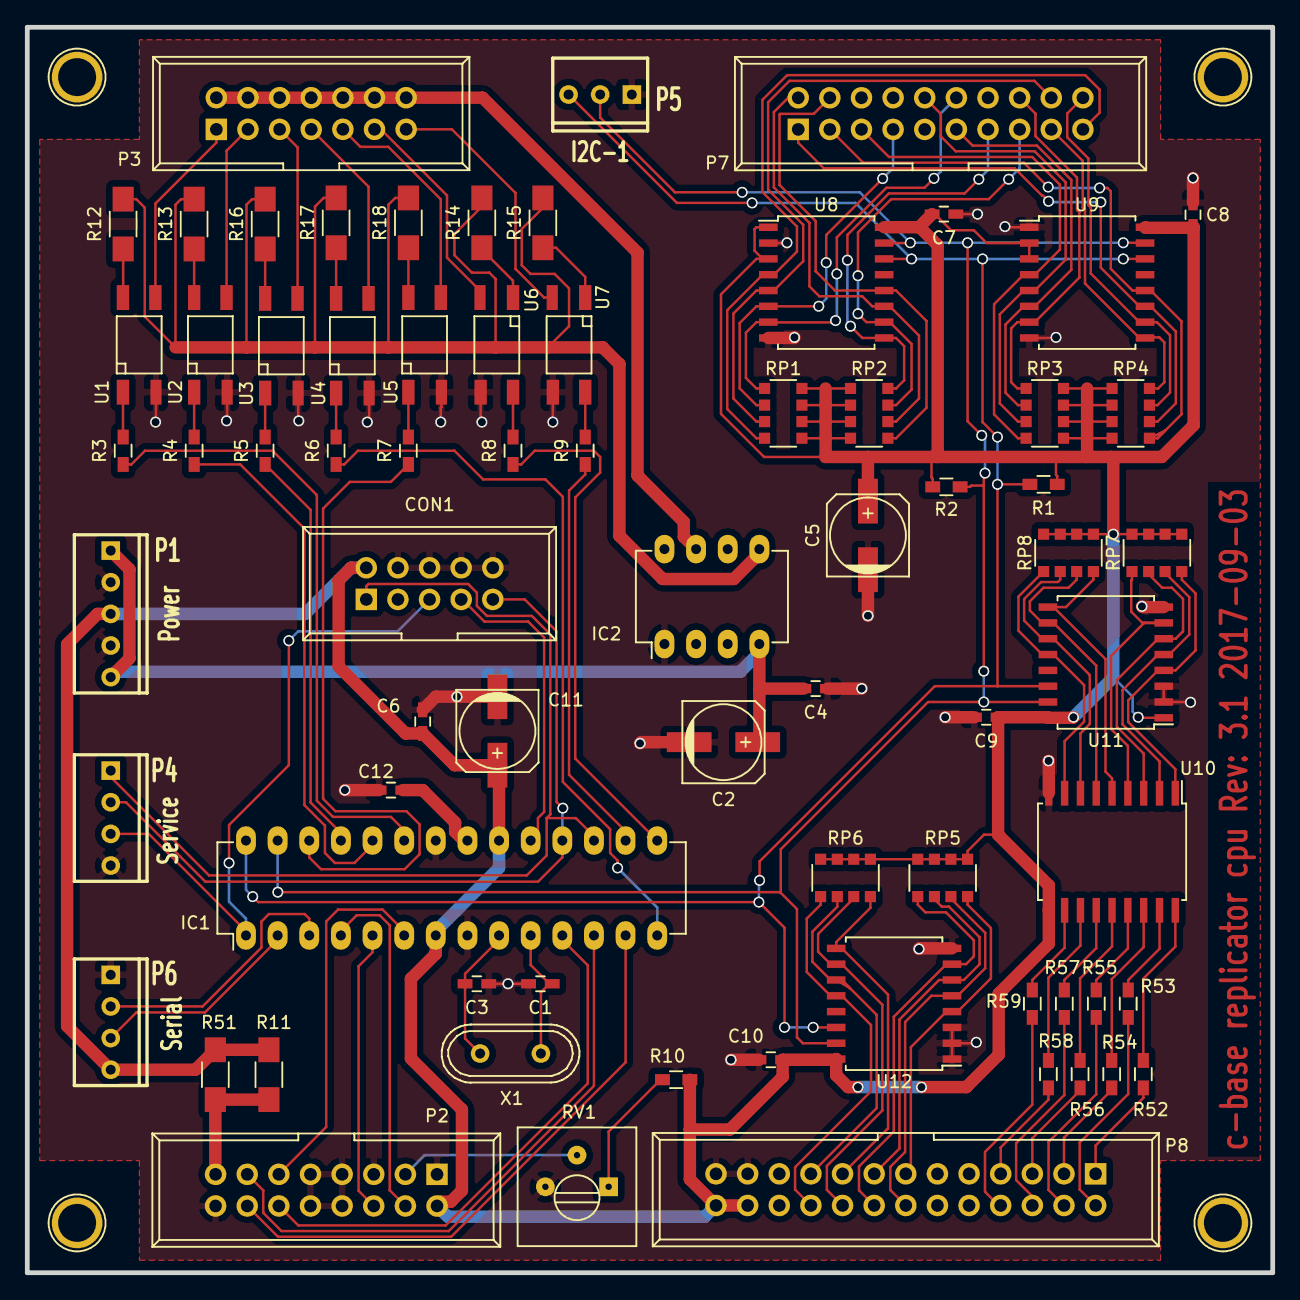
[picture p12: board logic.kicad_pcb from above]

Board: 2 copper layers, 100.0 x 100.0 mm, 72 parts (0 on the bottom side), 101 nets.
