c-MM/c-replicator/(commit log)

2019-01-20 add prototype for connector panel
    [replicator-panel-v1.stl]
2019-01-20 next prototype for connector panel
    [replicator-panel-v1.stl]
2019-01-20 add openscad source for connector panel
    [replicator-panel.scad]
2019-01-20 add mounting holes
    [replicator-panel-v1.stl, replicator-panel.scad]
2019-01-20 remove unused tests
    [replicator-panel.scad]
2019-01-20 turn make top inforcement for better printing
    [replicator-panel-v1.stl, replicator-panel.scad]
2019-01-20 make it 4mm smaller
    [replicator-panel-v1.stl, replicator-panel.scad]
2019-01-26 add openscad and stl for cashbox
    [replicator-cashbox-v1.stl, replicator-cashbox.scad]
2019-01-27 add holder for service buttons
    [replicator-buttons-panel-v1.stl, replicator-buttons-panel.scad]
2019-01-30 add kicad files
    [logic-cpu.sch, logic-io.sch, logic.kicad_pcb, logic.sch, power.kicad_pcb, power.sch]
2019-01-30 add schematics in pdf
2019-01-31 add kicad symbol libs and remove *.lib from .gitignore
2019-05-02 fix status tx length, only count vends when not reseting slots
2019-05-02 add counter reset command, don't increase error counter on too litle credit, show disables slots as blocked ind status command
2019-05-03 rename 3d-print files
    [replicator-ZEN6-buttons-panel-v1.stl, replicator-ZEN6-buttons-panel.scad, replicator-ZEN6-cashbox-v1.stl, replicator-ZEN6-cashbox.scad, replicator-ZEN6-connector_holder-v1.stl, replicator-ZEN6-connector_holder.scad]
2019-05-04 add comand to dispense slot
