c-MM/c-replicator/(notices)

Notices in the files:
replicator-fw/replicator.c:
license: This program is free software; you can redistribute it and/or
